patrickyeon/hackhat/hw/particle_sensor/outputs/particle_sensor.pdf

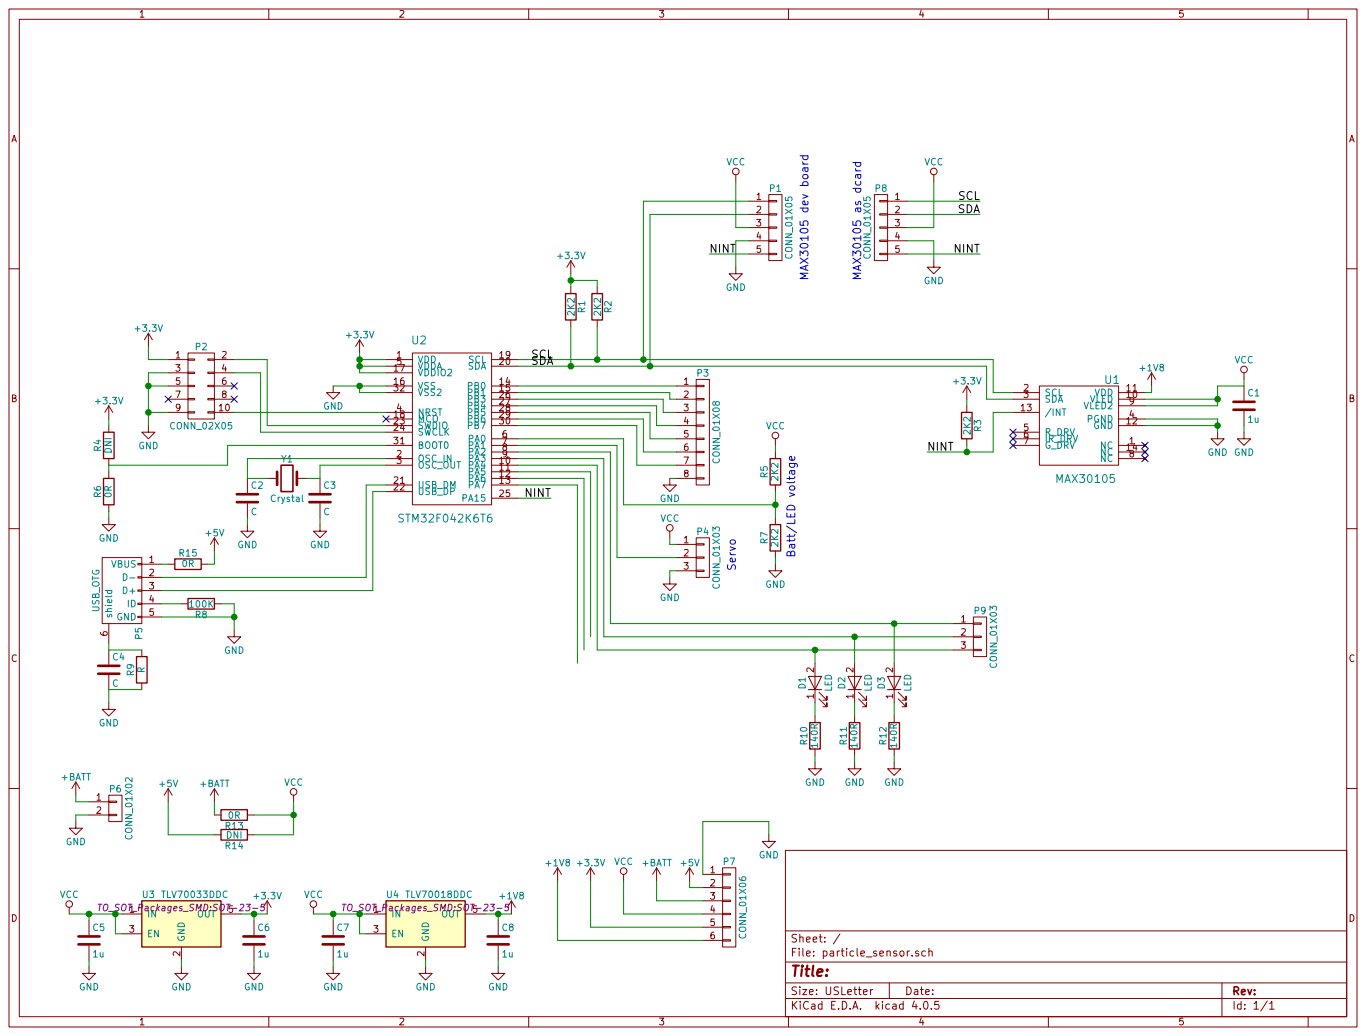
[picture p1: page 1]

1 2 D3 LED R10 140R R11 140R R12 140R GND GND GND
