patrickyeon/hackhat/hw/particle_sensor/particle_sensor.kicad_pcb

## KiCad design hw/particle_sensor/particle_sensor.kicad_pcb (2018-08-31)

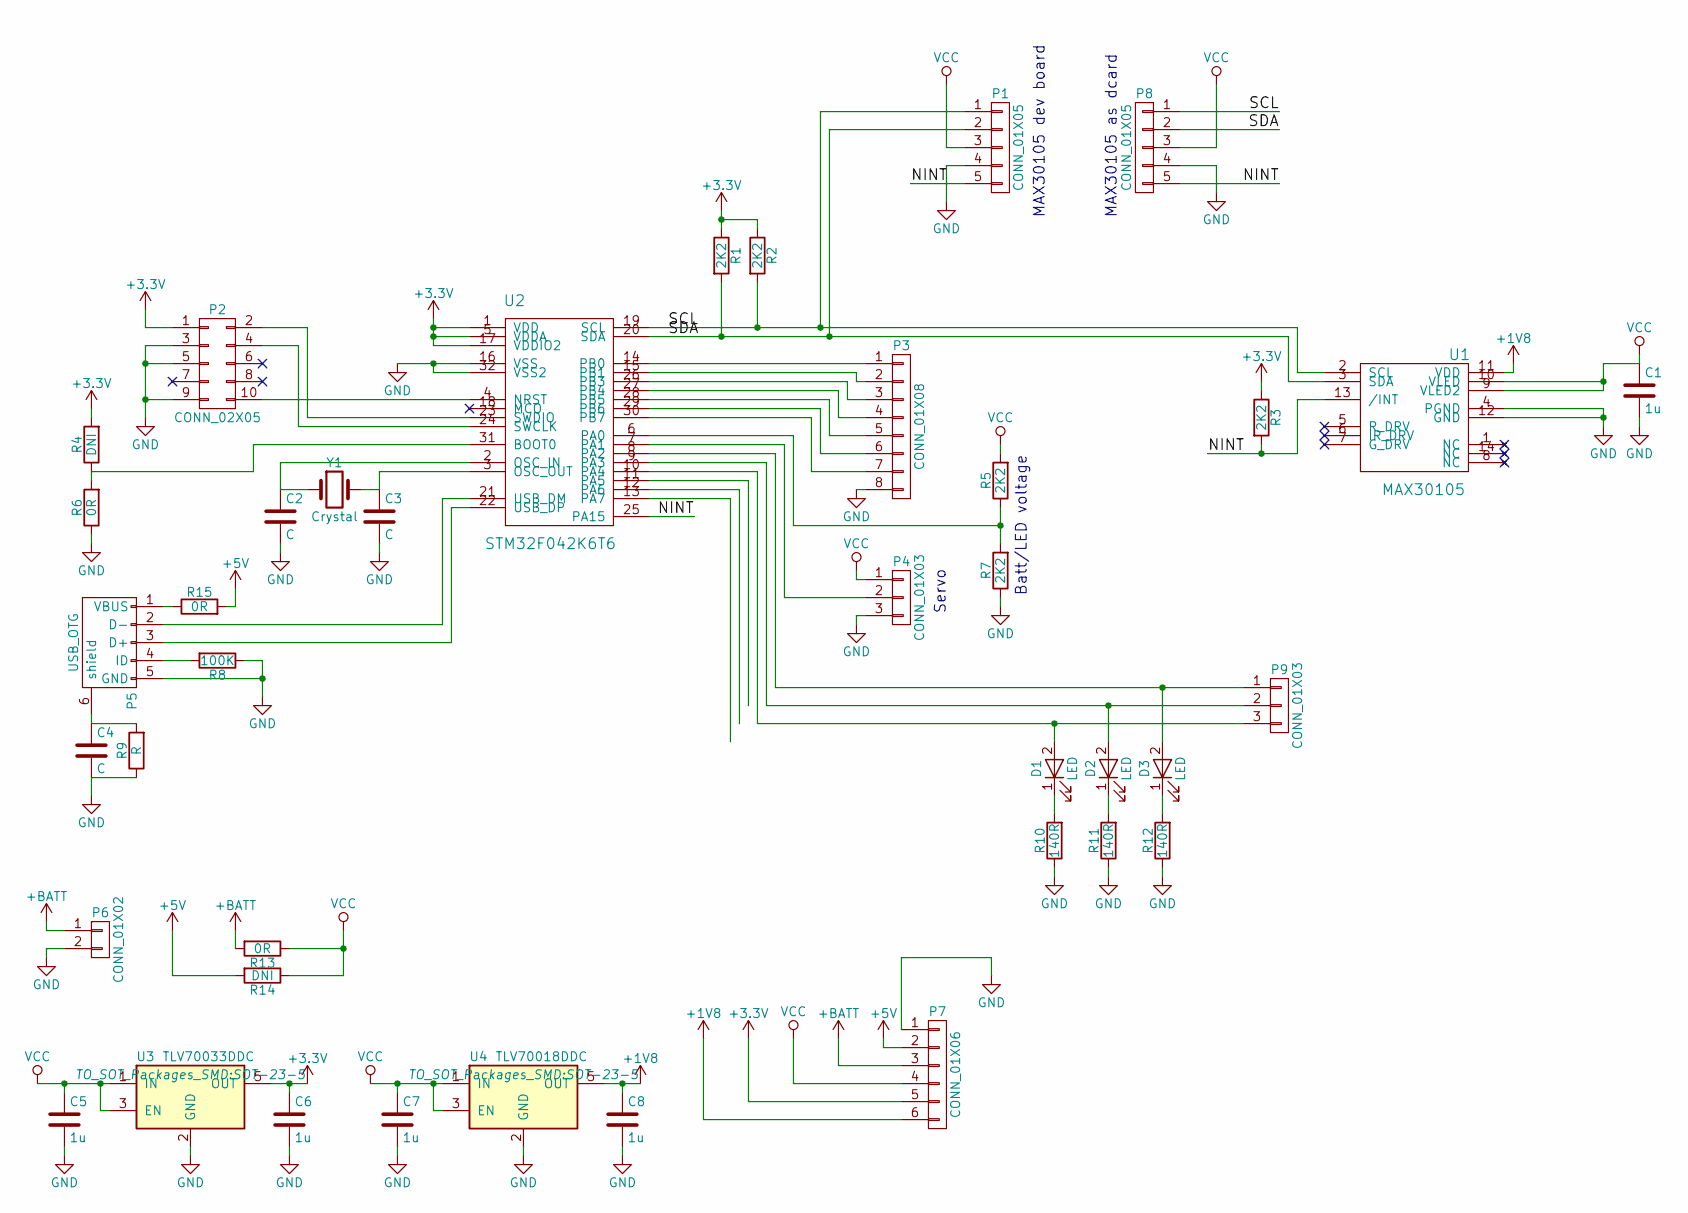
[picture p2: schematic particle_sensor.sch]

Parts:
C1, C5, C6, C7, C8: 1u; C_0603
C2, C3, C4: C; C_0603
D1, D2: LED; LED_2.1X1.6_RA
D3: LED; LED_2.1X1.6_RA; Digikey PN 1497-1175-1-ND
P1, P8: CONN_01X05; Socket_Strip_Straight_1x05
P2: CONN_02X05; CONN_JTAG_10; Digikey PN 1175-1629-ND
P3: CONN_01X08; Socket_Strip_Straight_1x08
P4, P9: CONN_01X03; Socket_Strip_Straight_1x03
P5: USB_OTG; USB_Micro-B
P6: CONN_01X02; Socket_Strip_Straight_1x02
P7: CONN_01X06; Socket_Strip_Straight_1x06
R1, R2, R3, R5, R7: 2K2; R_0603
R4, R14: DNI; R_0603
R6, R13, R15: 0R; R_0603
R8: 100K; R_0603
R9: R; R_0603
R10, R11, R12: 140R; R_0603
U1: MAX30105; 14_OESIP
U2: STM32F042K6T6; LQFP-32_7x7mm_Pitch0.8mm
U3: TLV70033DDC; SOT-23-5
U4: TLV70018DDC; SOT-23-5
Y1: Crystal; Crystal_HC49-SD_SMD

Connections:
+1V8: C8.1, P7.6, U1.11 (VDD), U4.5 (OUT)
+3V3: C6.1, P2.1, P7.5, R1.1, R2.1, R3.1, R4.2, U2.1 (VDD), U2.5 (VDDA), U2.17 (VDDIO2), U3.5 (OUT)
+5V: P7.2, R14.2, R15.2
+BATT: P6.1, P7.3, R13.2
/NINT: P1.5, P8.5, R3.2, U1.13 (/INT), U2.25 (PA15)
/SCL: P1.1, P8.1, R2.2, U1.2 (SCL), U2.19 (SCL)
/SDA: P1.2, P8.2, R1.2, U1.3 (SDA), U2.20 (SDA)
GND: C1.2, C2.2, C3.2, C4.2, C5.2, C6.2, C7.2, C8.2, P1.4, P2.3, P2.5, P2.9, P3.8, P4.3, P5.5 (GND), P6.2, P7.1, P8.4, R6.1, R7.1, R8.1, R9.1, R10.1, R11.1, R12.1, U1.4 (PGND), U1.12 (GND), U2.16 (VSS), U2.32 (VSS2), U3.2 (GND), U4.2 (GND)
unnamed: C2.1, U2.2 (OSC_IN), Y1.1
unnamed: C3.1, U2.3 (OSC_OUT), Y1.2
unnamed: C4.1, P5.6 (shield), R9.2
unnamed: D1.1 (K), R10.2
unnamed: D1.2 (A), P9.3, U2.10 (PA4)
unnamed: D2.1 (K), R11.2
unnamed: D2.2 (A), P9.2, U2.9 (PA3)
unnamed: D3.1 (K), R12.2
unnamed: D3.2 (A), P9.1, U2.8 (PA2)
unnamed: P2.2, U2.23 (SWDIO)
unnamed: P2.4, U2.24 (SWCLK)
unnamed: P2.10, U2.4 (NRST)
unnamed: P3.1, U2.14 (PB0)
unnamed: P3.2, U2.15 (PB1)
unnamed: P3.3, U2.26 (PB3)
unnamed: P3.4, U2.27 (PB4)
unnamed: P3.5, U2.28 (PB5)
unnamed: P3.6, U2.29 (PB6)
unnamed: P3.7, U2.30 (PB7)
unnamed: P4.2, U2.7 (PA1)
unnamed: P5.1 (VBUS), R15.1
unnamed: P5.2 (D-), U2.21 (USB_DM)
unnamed: P5.3 (D+), U2.22 (USB_DP)
unnamed: P5.4 (ID), R8.2
unnamed: R4.1, R6.2, U2.31 (BOOT0)
unnamed: R5.1, R7.2, U2.6 (PA0)
VCC: C1.1, C5.1, C7.1, P1.3, P4.1, P7.4, P8.3, R5.2, R13.1, R14.1, U1.9 (VLED2), U1.10 (VLED), U3.1 (IN), U3.3 (EN), U4.1 (IN), U4.3 (EN)

Notes on the sheet:
MAX30105 dev board
Servo
Batt/LED voltage
MAX30105 as dcard

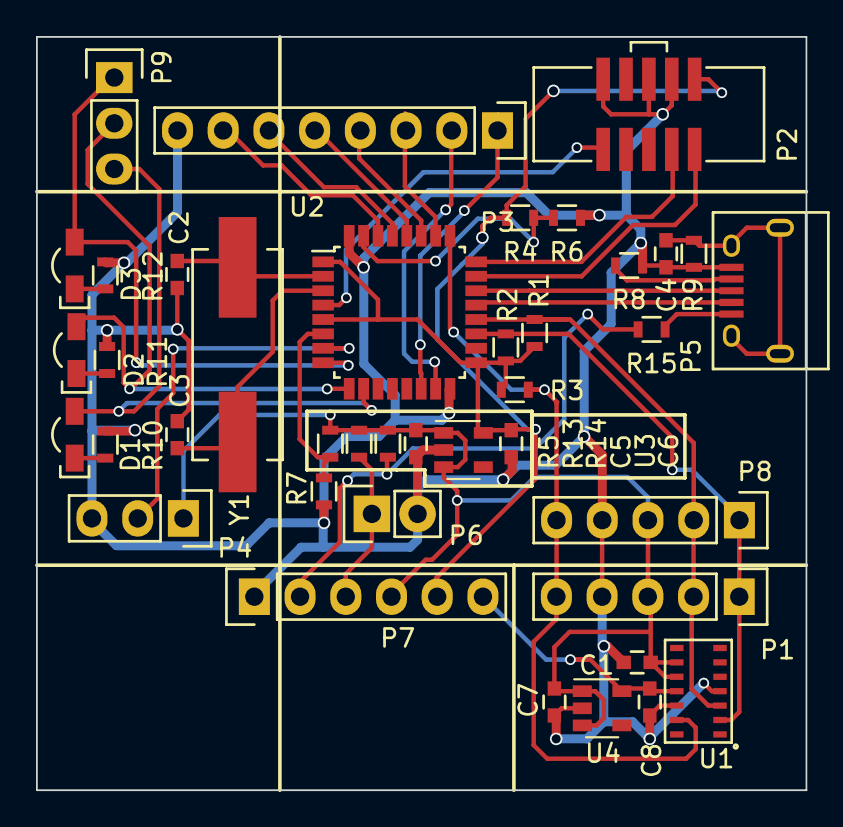
[picture p3: board particle_sensor.kicad_pcb from above]

Board: 2 copper layers, 42.8 x 41.8 mm, 40 parts (0 on the bottom side), 35 nets.
