patrickyeon/hackhat/(commit log)

2018-01-28 initial commit, LEDs and USB
2018-01-28 Adding Unity unit testing framework
2018-01-29 multi-ringbuffer fixed, and some simple USB control
    [main.c, usb.c]
2018-08-27 basic timing and servo control
2018-08-27 more lightweight LED PWMing
2018-08-28 barebones i2c with particle sensor working (read temperature)
2018-08-31 re-org, importing hardware design
    [particle_sensor.BOR.gbr, particle_sensor.GBL, particle_sensor.GBO, particle_sensor.GBP, particle_sensor.GBS, particle_sensor.GTL, particle_sensor.GTO, particle_sensor.GTP]
2018-09-03 routine to try to avoid overflowing the ALC
    [demo.c, max30105.c, max30105.h]
